freylax/masonry-heater/masonry-heater/calc.org

#+TITLE:     Berechnungen Grundofen Coswiger Str 1
#+AUTHOR:    Robert Hennig
#+EMAIL:     robert.hennig@freylax.de
#+DATE:      2018-08-8 
#+DESCRIPTION: 
#+KEYWORDS: 
#+LANGUAGE:  en
#+OPTIONS:   H:3 toc:2 \n:nil @:t ::t |:t ^:{} -:t f:t *:t <:t
#+OPTIONS:   TeX:t LaTeX:nil skip:nil d:nil todo:t pri:nil tags:not-in-to
#+LATEX_CLASS: articleAivSmall
#+LATEX_HEADER: \usepackage{fancyhdr}
#+LATEX_HEADER: \usepackage{pdfpages}
#+LATEX_HEADER: \usepackage{tabulary}
#+LATEX_HEADER: \pagestyle{fancy}
#+LATEX_HEADER: \fancyhead{} % clear all fields
#+LATEX_HEADER: \fancyhead[RO,LE]{\thepage}
#+LATEX_HEADER: \fancyhead[C]{\slshape\nouppercase{\leftmark}}
#+LATEX_HEADER: \fancyfoot[RO,LE]{\thepage}
#+LATEX_HEADER: \fancyfoot[C]{\slshape Grundofen, Coswiger Str 1, 01445 Radebeul}
#+LATEX_HEADER: \setlength{\headsep}{10pt}
#+LATEX_HEADER: \addtolength{\headheight}{\baselineskip}
#+LATEX_HEADER: \renewcommand{\headrulewidth}{0.4pt}
#+LATEX_HEADER: \renewcommand{\footrulewidth}{0.4pt}
#+INFOJS_OPT: view:nil toc:nil ltoc:t mouse:underline buttons:0 path:http://orgmode.org/org-info.js
#+EXPORT_SELECT_TAGS: export
#+EXPORT_EXCLUDE_TAGS: noexport
#+LATEX_COMPILER: latexmk
#+LINK_UP:   
#+LINK_HOME:

* Grundofenberechnung nach EN 15544 cite:EN15544
** Bestimmung der Nennwärmeleistung (4.1)
   Die aktive Oberfläche des Ofens sind rund $5 m²$.
   Es wird ein mittelschwerer Grundofen errichtet,
   dafür gilt nach cite:Herrmann2011, Seite 229 
\begin{align}
P_n & = A_{GO} \cdot q_{GO} \\
    & = 5 m^2 \cdot 0.75 kW/m^2 = 3.75 kW
\end{align}
** Bestimmung der Brennstoffmasse (4.2)
*** Maximale Brennstoffmasse (4.2.1)
Es eine Speicherdauer von $t_n=8h$ vereinbart, so daß
\begin{align}
m_B & = \frac{P_n \cdot t_n}{3.25} \\
    & = \frac{3.75 \cdot 8}{3.25} & = 9.2 kg
\end{align}
*** Minimale Brennstoffmasse (4.2.2)
\begin{equation}
m_{Bmin} = 0.5 \cdot m_B = 0.5 \cdot 9.2 kg = 4.6 kg
\end{equation}

** Festlegung der wesentlichen Abmessungen (4.3)
*** Brennraum-Innenfläche (4.3.1.1)
\begin{equation}
O_{BR}= 900 \cdot m_{B} = 900 \cdot 9.2 = 8280 cm^2
\end{equation}
*** Brennraum-Grundfläche (4.3.1.2)
\begin{equation}
A_{BRmin}=100 \cdot m_B = 100 \cdot 9.2 = 920 cm^2
\end{equation}
Es wird eine Brennraum Grundfläche von $A_{BR} = 36 cm \times 36 cm = 1296 cm^2$ vereinbart.
\begin{align}
A_{BRmax}& =\frac{900 \cdot m_B - ( 25 + m_B) \cdot U_{BR}}{2} \\
         & =\frac{900 \cdot 9.2 - ( 25 + 9.2) \cdot 4 \cdot 36}{2} = 1677 cm^2
\end{align}
Es ist
\begin{align}
	A_{BRmin} &\le A_{BR} &\le A_{BRmax} \\
	920 cm^2  &\le 1296 cm^2  &\le 1677 cm^2
\end{align}
und die minimale Seitenbreite von $23 cm$ wird eingehalten.
*** Brennraumhöhe (4.3.1.3)
\begin{align}
H_{BR} &\ge 25 + m_B = 25 + 9.2 = 34.2 cm \\
H_{BR} &= \frac{900\cdot m_B - 2 \cdot A_{BR}}{U_{BR}} = \frac{900\cdot 9.2 - 2 \cdot 36 \cdot 36}{4 \cdot 36} = 39.5 cm
\end{align}
Die Brennraumhöhe wird auf $H_{BR} = 40 cm$ festgelegt.

*** Mindestzuglänge (4.3.2.1)
Der Grundofen wird ohne Luftspalt gebaut, dh die Mindestzuglänge ergibt sich zu
\begin{equation}
 L_{Zmin} = 1.3 \cdot \sqrt{m_B} = 1.3 \cdot \sqrt{9.2} = 3.94 m
\end{equation}
*** Gasschlitzquerschnitt (4.3.3)
\begin{equation}
A_{GS} = 1 \cdot m_B = 1 \cdot 9.2 = 9.2 cm^2
\end{equation}

** Verbrennungsluft, Verbrennungsgas
*** Seehöhen-Korrektur (4.6.1.2)
Die geodätische Höhe des Aufstellungsortes ist $ z = 110 m $.
\begin{equation}
f_s = \frac{1}{e^\frac{-9.81 \cdot z}{78624}} = \frac{1}{e^\frac{-9.81 \cdot 110}{78624}} = 1.0138 
\end{equation}

** Temperatur und Druckbedingungen in den Zügen
*** Zuglaengen
Auf der nächsten Seite sind die Züge dargestellt und
in Tabelle [[tbl:zuege]] aufgeführt.    
#+LATEX: \includepdf[pagecommand={},lastpage=1,scale=1]{zuglaengen.pdf}

#+CAPTION: Zuglängen und \zeta Werte
#+NAME: tbl:zuege
|   |      n | $a$ | $b$ | $r$ | \alpha | $L_Z$ | $D_h$ | \zeta |
|   |        |  cm |  cm |  cm |    deg |    cm |    cm |       |
| ! |        |   a |   b |   r |    ang |     l |    Dh |     c |
|---+--------+-----+-----+-----+--------+-------+-------+-------|
| # |      1 |  36 |  36 |     |     90 |    40 |    36 |   1.2 |
| # |      2 |  17 |  17 |     |     90 |    20 |    17 |   1.2 |
| # |      3 |  17 |  17 |     |     90 |    63 |    17 |   1.2 |
| # |      4 |  17 |  17 |     |      0 |    23 |    17 |     0 |
| # |      5 |  17 |  17 |  27 |     96 |    45 |    17 |     1 |
| # |      6 |  17 |  17 |  36 |    111 |    70 |    17 |   1.1 |
| # |      7 |  17 |  17 |     |        |    76 |    17 |     0 |
| # |      8 |  17 |  17 |  31 |     68 |    37 |    17 |   0.8 |
| # |      9 |  17 |  17 |     |        |    38 |    17 |     0 |
| # |     10 |  17 |  17 |  25 |     75 |    33 |    17 |   0.8 |
| # |     11 |  17 |  17 |     |        |    79 |    17 |     0 |
| # |     12 |  15 |  17 |  35 |    109 |    67 |    16 |   1.2 |
| # |     13 |  15 |  17 |     |        |    19 |    16 |     0 |
| # |     14 |  15 |  17 |  18 |     90 |    28 |    16 |   1.1 |
| # |     15 |  15 |  17 |     |        |    35 |    16 |   1.2 |
| # |     16 |  15 |  17 |     |        |   103 |    16 |   0.2 |
| # | vst 17 |  17 |  17 |     |        |    17 |    17 |     0 |
| # | vst 18 |  17 |  17 |  12 |     90 |    19 |    17 |   0.4 |
| # | vst 19 |  17 |  17 |     |        |    26 |    17 |   1.2 |
#+TBLFM: $7=(3.14/180)*$ang*$r;%.0f::$8=(4*$a*$b)/(2*($a+$b));%.0f::@4$7=40::@5$7=20::@6$7=63::@7$7=23::@10$7=76::@12$7=38::@14$7=79::@16$7=19::@18$7=35::@19$7=103::@20$7=17::@22$7=26

*** Temperatur und Druckverlauf in den Zügen
In Tabelle [[tbl:tpz]] ist der Temperatur und Druckverlauf in den Zügen dargestellt.
Der Temperaturverlauf in Verbindungsstück und Schornstein kommt aus den Berechnungen 
aus Abschnitt [[sec:abgas]]

#+LATEX: \begin{landscape}

#+ATTR_LATEX: :font \small
#+ATTR_LATEX: :environment tabulary :width \textwidth :spread
#+CAPTION: Temperatur und Druckverlauf in den Zügen
#+NAME: tbl:tpz 
|   |          Zug | $L_Z$ |  $H$ |  $a$ | $b$ | \zeta | $\sum L_Z$ |   $t$ |     $f_t$ | $\dot{V_G}$ | $\rho_G$ | $p_h$ |   $A$ |  $U$ |   $D_h$ |    $v$ |   $p_d$ | $\lambda_f$ |   $p_r$ |  $p_u$ |
| ! |              |    Lz |    H |    a |   b |     c |        Lzs |     t |        ft |          VG |       rG |    pH |     A |    U |      Dh |      v |      pd |          lf |      pr |     pu |
|   |              |     m |    m |   cm |  cm |       |          m |    °C |           |        m³/s |    kg/m³ |    Pa |    m² |    m |       m |    m/s |      Pa |             |      Pa |     Pa |
|   |              |       |      |      |     |       |            | 4.8.2 |   4.6.1.1 |       4.6.2 |    4.7.2 | 4.9.1 |       |      | 4.9.3.4 |  4.9.2 | 4.9.3.2 |     4.9.3.3 | 4.9.3.1 |  4.9.4 |
|---+--------------+-------+------+------+-----+-------+------------+-------+-----------+-------------+----------+-------+-------+------+---------+--------+---------+-------------+---------+--------|
|   |              |       |      |      |     |       |            |       |           |             |          |       |       |      |         | 1.2..6 |         |             |         |      4 |
| # |              |  0.05 |    0 |   12 |   4 |  0.15 |       0.05 |    18 |     1.066 |       0.027 |    1.186 |  0.00 | 0.005 | 0.32 |   0.062 |  5.400 |  17.292 |       0.070 |   0.976 |  2.594 |
|---+--------------+-------+------+------+-----+-------+------------+-------+-----------+-------------+----------+-------+-------+------+---------+--------+---------+-------------+---------+--------|
| # |            1 |  0.40 |  .40 |   36 |  36 |   1.2 |       0.45 |   700 |     3.564 |       0.091 |    0.355 |  3.57 | 0.130 | 1.44 |   0.361 |  0.700 |   0.087 |       0.036 |   0.003 |  0.104 |
|---+--------------+-------+------+------+-----+-------+------------+-------+-----------+-------------+----------+-------+-------+------+---------+--------+---------+-------------+---------+--------|
| # |            2 |   .20 |    0 |   16 |  10 |   1.2 |       0.65 |   495 |     2.813 |       0.072 |    0.450 |  0.00 | 0.016 | 0.52 |   0.123 |  4.500 |   4.556 |       0.052 |   0.385 |  5.467 |
| # |            3 |   .63 | -.63 |   17 |  17 |   1.2 |       1.28 |   454 |     2.663 |       0.068 |    0.475 | -4.88 | 0.029 | 0.68 |   0.171 |  2.345 |   1.306 |       0.046 |   0.221 |  1.567 |
| # |            4 |   .23 |    0 |   17 |  17 |     0 |       1.51 |   414 |     2.516 |       0.064 |    0.503 |  0.00 | 0.029 | 0.68 |   0.171 |  2.207 |   1.225 |       0.046 |   0.076 |  0.000 |
| # |            5 |   .45 |    0 |   17 |  17 |   1.0 |       1.96 |   386 |     2.414 |       0.061 |    0.524 |  0.00 | 0.029 | 0.68 |   0.171 |  2.103 |   1.159 |       0.046 |   0.140 |  1.159 |
| # |            6 |   .70 |    0 |   17 |  17 |   1.1 |       2.66 |   342 |     2.253 |       0.057 |    0.561 |  0.00 | 0.029 | 0.68 |   0.171 |  1.966 |   1.084 |       0.046 |   0.204 |  1.192 |
| # |            7 |   .76 |    0 |   17 |  17 |     0 |       3.42 |   293 |     2.073 |       0.053 |    0.610 |  0.00 | 0.029 | 0.68 |   0.171 |  1.828 |   1.019 |       0.046 |   0.208 |  0.000 |
| # |            8 |   .37 |    0 |   17 |  17 |   0.8 |       3.79 |   260 |     1.952 |       0.050 |    0.648 |  0.00 | 0.029 | 0.68 |   0.171 |  1.724 |   0.963 |       0.046 |   0.096 |  0.770 |
| # |            9 |   .38 |    0 |   17 |  17 |     0 |       4.17 |   240 |     1.879 |       0.048 |    0.673 |  0.00 | 0.029 | 0.68 |   0.171 |  1.655 |   0.922 |       0.046 |   0.094 |  0.000 |
| # |           10 |   .33 |    0 |   17 |  17 |   0.8 |        4.5 |   223 |     1.817 |       0.046 |    0.696 |  0.00 | 0.029 | 0.68 |   0.171 |  1.586 |   0.875 |       0.046 |   0.078 |  0.700 |
| # |           11 |   .79 |    0 |   16 |  17 |     0 |       5.29 |   198 |     1.725 |       0.044 |    0.733 |  0.00 | 0.027 | 0.66 |   0.164 |  1.630 |   0.974 |       0.047 |   0.221 |  0.000 |
| # |           12 |   .67 |    0 |   15 |  17 |   1.2 |       5.96 |   170 |     1.623 |       0.041 |    0.779 |  0.00 | 0.025 | 0.64 |   0.156 |  1.640 |   1.048 |       0.048 |   0.216 |  1.258 |
| # |           13 |   .19 |    0 |   15 |  17 |     0 |       6.15 |   155 |     1.568 |       0.040 |    0.806 |  0.00 | 0.025 | 0.64 |   0.156 |  1.600 |   1.032 |       0.048 |   0.060 |  0.000 |
| # |           14 |   .28 |    0 |   15 |  17 |   1.1 |       6.43 |   148 |     1.542 |       0.039 |    0.820 |  0.00 | 0.025 | 0.64 |   0.156 |  1.560 |   0.998 |       0.048 |   0.086 |  1.098 |
| # |           15 |   .35 |    0 |   15 |  17 |   1.2 |       6.78 |   138 |     1.505 |       0.038 |    0.840 |  0.00 | 0.025 | 0.64 |   0.156 |  1.520 |   0.970 |       0.048 |   0.104 |  1.164 |
| # |           16 |  1.03 | 1.03 |   15 |  17 |   0.2 |       7.81 |   120 |     1.440 |       0.037 |    0.878 |  3.90 | 0.025 | 0.64 |   0.156 |  1.480 |   0.962 |       0.048 |   0.305 |  0.192 |
|---+--------------+-------+------+------+-----+-------+------------+-------+-----------+-------------+----------+-------+-------+------+---------+--------+---------+-------------+---------+--------|
| # |          vst |  0.62 | 0.29 | 17.0 |     |   1.4 |       8.43 |   118 |     1.432 |       0.036 |    0.883 |  1.08 | 0.023 | 0.53 |   0.174 |  1.565 |   1.081 |       0.040 |   0.154 |  1.513 |
| # |          sch |   7.1 |  7.1 | 17.8 |     |  0.01 |      15.53 |   108 |     1.396 |       0.036 |    0.906 | 24.94 | 0.025 | 0.56 |   0.179 |  1.440 |   0.939 |       0.039 |   1.453 |  0.009 |
|---+--------------+-------+------+------+-----+-------+------------+-------+-----------+-------------+----------+-------+-------+------+---------+--------+---------+-------------+---------+--------|
| # | $\sum total$ |       |      |      |     |       |      15.53 |    98 |           |             |          | 28.61 |       | 0.00 |         |        |  38.492 |             |    5.08 | 22.787 |
| ^ |              |       |      |      |     |       |            |       |           |             |          |   SpH |       |      |         |        |     SpD |             |     Spr |    Spu |
| # |  $\sum ofen$ |       |      |      |     |       |            |       |           |             |          |  2.59 |       |      |         |        |         |             |   2.497 | 14.671 |
| ^ |              |       |      |      |     |       |            |       |           |             |          |  SpHo |       |      |         |        |         |             |    Spro |   Spuo |
| $ |              |       |      |      |     |       |            |       |  Lzm=3.94 |      mB=9.2 | rL=1.264 |       |       |      |         |        |         |             |         |        |
| $ |              |       |      |      |     |       |            |       | fs=1.0138 |             |          |       |       |      |         |        |         |             |         |        |
#+TBLFM: $8=$Lz+@-1$Lzs::$10=(273+$t)/273;%.3f::$11=0.00273*$mB*($ft*$fs;%.3f::$12=1.282/($ft*$fs);%.3f::$13=9.81*$H*($rL-$rG);%.2f::$16=4.*$A/$U;%.3f::$17=$VG/$A;%.3f::$18=0.5*$rG*$v*$v;%.3f::$20=$lf*$pd*$Lz/$Dh;%.3f::$21=$c*$pd;%.3f::@6$14..@22$14=$a*$b/10000;%.3f::@6$15..@22$15=2*($a+$b)/100;%.2f::@6$19..@22$19=1/(1.14+2*log10($Dh/0.003))^2;%.3f::@8$9..@22$9=550*exp(-0.83*($Lzs-$Lz/2-@II-1$Lzs)/$Lzm);%.0f::@23$9=remote(tbl:TempT,@5$tmv)::@23$14..@24$14=0.785*$a*$a/10000;%.3f::@23$15..@24$15=3.14*$a/100;%.2f::@23$19..@24$19=1/(1.14+2*log10($Dh/0.002))^2;%.3f::@24$9=remote(tbl:TempT,@5$tm)::@25$10=string("")::@25$11=string("")::@25$12=string("")::@25$13=vsum(@5..@24)::@25$14=string("")::@25$16=string("")::@25$17=string("")::@25$18=vsum(@5..@24)::@25$19=string("")::@25$20=vsum(@5..@24)::@25$21=vsum(@5..@24)::@27$8=string("")::@27$10=string("")::@27$11=string("")::@27$12=string("")::@27$13=vsum(@II..@IIII)::@27$16=string("")::@27$17=string("")::@27$18=string("")::@27$20=vsum(@II..@IIII)::@27$21=vsum(@II..@IIII)

#+LATEX: \end{landscape}

*** Funktionskontrolle (4.10)

#+CAPTION: Druckvergleich, Wirkungsgrad
#+NAME: tbl:pcomp
|   | $\sum p_r+ \sum p_u \le$ | $\sum p_h$ | $\le 1.05\cdot (\sum p_r+ \sum p_u)$ | $t_F$ |   \eta |
|   | Pa                       | Pa         |                                   Pa | °C    |        |
|   |                          |            |                               4.10.1 |       | 4.10.3 |
|---+--------------------------+------------+--------------------------------------+-------+--------|
| ! |                          |            |                                      | tF    |        |
| # | 27.87                    | 28.61      |                                29.26 | 120   | 89.653 |
#+TBLFM: @5$2=remote(tbl:tpz,$Spr)+remote(tbl:tpz,$Spu);%.2f::@5$3=remote(tbl:tpz,$SpH)::@5$4=1.05*$2;%.2f::@5$5=remote(tbl:tpz,@22$t)::@5$6=101.09-0.0941*$tF-6.275e-6*$tF^2-3.173*10e-9*$tF^3;%.3f

In der Tabelle [[tbl:pcomp]] sind die Ergebnisse dargestellt.
Da sich die Druckwerte im Schornstein und Verbindungsstück je nach Berechnungsmodell (EN 13384-1 ist feiner als EN 15544) 
unterscheiden wurden in Tabelle [[tbl:pcomp2]] die Druckwertewerte aus der Berechnung nach EN 13384-1 eingesetzt (Tabelle [[tbl:psch]]),
und mit den Werten vom Ofen aus Tabelle [[tbl:tpz]]  kombiniert. $P_B'$ ist die Summe aus $P_B=4Pa$ und dem Druck durch die Luftzufuhr
des Ofen, welche in etwa den Werten aus Tabelle [[tbl:tpz]] entspricht.

#+CAPTION: Druckvergleich nach EN 13384-1 und EN 15544
#+NAME: tbl:pcomp2
|   | $P_B'$ | $\sum p_{ru} \le$ | $\sum p_H$ | \le $1.05 \cdot \sum p_{ru}$ |
|   | Pa     | Pa                | Pa         | Pa                           |
|---+--------+-------------------+------------+------------------------------|
| ! | PB     | SPRU              |            |                              |
| # | 6.7    | 26.5              |       27.7 | 27.8                         |
#+TBLFM: $3=remote(tbl:tpz,$Spro)+remote(tbl:tpz,$Spuo)+remote(tbl:psch,$PR1)+remote(tbl:psch,$PR2)+$PB;%.1f::$4=remote(tbl:tpz,$SpHo)+remote(tbl:psch,$PH1)+remote(tbl:psch,$PH2);%.1f::$5=1.05*$SPRU;%.1f

* Berechnung Abgasanlage nach EN 13384-1 cite:EN13384
 <<sec:abgas>>
** Wärmedurchlasswiderstand für den Schornstein (5.6.3)
#+CAPTION: Wärmedurchlasswiderstand für Schornstein
|   | Schicht      | $D_h$ | $\lambda$      | $1/\Lambda$    |
|   |              |   $m$ | $W/(m\cdot K)$ | $m^2\cdot K/W$ |
|   |              |       | B.5            | A.1            |
|---+--------------+-------+----------------+----------------|
| ! |              |    Dh | lb             | Lr             |
| # | Keramikrohr  | 0.178 | 1.02           | 0.010          |
| # | Mineralwolle |  0.20 | 0.042          | 0.386          |
|   |              |  0.24 |                |                |
|   |              |       |                | 0.396          |
#+TBLFM: $5=(@5$Dh/(2*$lb))*ln(@+1$Dh/$Dh);%.3f::@8$5=vsum(@-3..@-1)

** Taupunkttemperatur 5.7.6
#+CAPTION: Taupunkttemperatur
 |   | Brennstoff          | $f_{m1}$ | $f_W$ | $\sigma(H_2O)$ | $z$ | $T$ | $p_L$ | $p_D$ | $t_p$ |
 |   |                     |          | %     | %              | m   | °C  |    Pa | Pa    | °C    |
 |   | $\sigma(CO_2)=20.5$ | B.1      | B.1   | B.5            |     |     | 5.7.2 | B.6   | B.7   |
 |---+---------------------+----------+-------+----------------+-----+-----+-------+-------+-------|
 | ! |                     | fm1      | fw    | sH2O           | z   | t   |    pL | pD    | tP    |
 | # | Holz 30% feucht     | 6.89     | 90    | 19.652         | 119 | 0   | 95570 | 18781 | 58.7  |
 | # | Holz 50% feucht     | 7.08     | 72    | 23.262         | 119 | 0   | 95570 | 22231 | 62.4  |
 | $ | sCO2=20.5           |          |       |                |     |     |       |       |       |
 #+TBLFM: $5=1.1+(100/(1+$fw/$sCO2));%.3f::$8=97000*exp(-9.81*$z/(288*($t+273)));%.0f::$9=($sH2O/100)*$pL;%.0f::$10=(4077.9/(23.6448-ln($pD)))-236.67;%.1f

#+LATEX: \begin{landscape}
** Temperaturwerte 5.8

#+CAPTION: Berechnung der Abkühlzahl K
#+NAME: tbl:TempK
#+ATTR_LATEX: :font \footnotesize
#+ATTR_LATEX: :environment tabulary :width \textwidth :spread
 |   |           |          | $\lambda_A$          | $L$  | $D_h$ | $\eta_A$       | $c_p$                 | $Pr$     | $R$                   | $\rho_m$ | $w_m$  | $Re$  | $\Psi$ | $\Psi_s$ | $Nu$  | $\alpha_i$            | $\frac{1}{\Lambda}$     | $D_{ha}$ | $k$                    | $K$   |
 |   |           | °C       | $\frac{W}{m\cdot K}$ | $m$  | $m$   | $N\cdot s/m^2$ | $\frac{J}{kg\cdot K}$ |          | $\frac{J}{kg\cdot K}$ | $kg/m³$  | $m/s$  |       |        |          |       | $\frac{W}{m²\cdot K}$ | $\frac{m^2 \cdot K}{W}$ | $m$      | $\frac{W}{m^2\cdot K}$ |       |
 |   |           |          | (B.9)                |      |       | (B.10)         | (B.4)                 | (25)     | (B.3)                 |          |        | (26)  | (35)   | (35)     | (24)  | (23)                  |                         |          | (21)                   | (20)  |
 |---+-----------+----------+----------------------+------+-------+----------------+-----------------------+----------+-----------------------+----------+--------+-------+--------+----------+-------+-----------------------+-------------------------+----------+------------------------+-------|
 | ! |           | tm       | lbA                  | L    | Dh    | nyA            | cP                    | Pr       | R                     | rm       | wm     | Re    | psi    | psis     | Nu    | ali                   | Lr                      | Dha      | k                      | K     |
 | # | vst       | 118      | 0.0300               | 0.62 | 0.170 | 2.027e-05      | 1210                  | 0.818    | 288.590               | 0.847    | 1.676  | 11906 | 0.0377 | 0.0295   | 56.93 | 10.046                | 0.01                    | 0.178    | 4.368                  | 0.037 |
 | ^ |           |          |                      |      | Dh1   |                |                       |          |                       |          |        | Re1   |        |          |       |                       |                         |          |                        | K1    |
 | # | sch       | 108      | 0.0293               | 7.1  | 0.178 | 1.984e-05      | 1207                  | 0.817    | 288.590               | 0.869    | 1.490  | 11617 | 0.0408 | 0.0297   | 44.67 | 7.353                 | 0.396                   | 0.24     | 1.601                  | 0.163 |
 | ^ |           |          |                      |      | Dh2   |                |                       |          |                       |          |        | Re2   |        |          |       |                       |                         |          |                        | K2    |
 | $ | sCO2=20.5 | fc0=18.5 | fc1=.016             |      |       | fc2=-1e-5      | fc3=0.0091            | pL=95570 | fR=0.0001             |          | mB=9.2 |       |        |          |       | ala=8                 |                         |          |                        |       |
 #+TBLFM: $4=0.0223+0.000065*$tm;%.4f::$7=15e-6 + (47e-9 * $tm) - (20e-12 * $tm^2);%.3e::$8=(1011+(0.05*$tm)+(0.0003*$tm^2)+(($fc0+($fc1*$tm)+($fc2*$tm^2))*$sCO2))/(1+($fc3*$sCO2));%.0f::$9=$nyA*$cP/$lbA;%.3f::$10=288*(1+($fR*$sCO2));%.3f::$11=$pL/($R*(273+$tm));%.3f::$12=$mB*0.0035/(0.785*$Dh^2*$rm);%.3f::$13=($wm*$Dh*$rm)/$nyA;%.0f::$16=($psi/$psis)^0.67 * 0.0214*($Re^0.8 - 100)*$Pr^0.4 *(1 + ($Dh/$L)^0.67);%.2f::$17=($lbA*$Nu)/$Dh;%.3f::$20=1/( (1/$ali) + $Lr + $Dh/($Dha*$ala));%.3f::$21=(3.14*$Dh*$k*$L)/($mB*0.0035*$cP);%.3f::@5$3=remote(tbl:TempT,@5$12);E::@5$14=remote(tbl:Psi,$psi1);%.4f::@5$15=remote(tbl:Psi,$psi1s);%.4f::@7$3=remote(tbl:TempT,@5$13);E::@7$14=remote(tbl:Psi,$psi2);%.4f::@7$15=remote(tbl:Psi,$psi2s);%.4f

#+CAPTION: Rohrreibungszahl $\Psi$ nach 5.10.3.3 (35) 
#+NAME: tbl:Psi
 |   |                |  $Re$ | $D_h$ |    $r$ | $\frac{1}{\sqrt{\Psi}}$ | $\Psi$      |
 |   |                |       |     m |      m |                         |             |
 |---+----------------+-------+-------+--------+-------------------------+-------------|
 | ! |                |    Re |    Dh |      r |                    wpsi | psi         |
 | # | $vst$          | 11981 |  0.17 |  0.001 |               5.1488606 | 0.037720525 |
 | ^ |                | 11906 |  0.17 |        |                         | psi1        |
 | # | $vst_{smooth}$ | 11981 |  0.17 |      0 |               5.8267813 | 0.029453883 |
 | ^ |                | 11906 |  0.17 |        |                         | psi1s       |
 | # | $sch$          | 11660 | 0.178 | 0.0015 |               4.9531167 | 0.040760817 |
 | ^ |                | 11617 | 0.178 |        |                         | psi2        |
 | # | $sch_{smooth}$ | 11660 | 0.178 |      0 |               5.8062571 | 0.029662481 |
 | ^ |                | 11617 | 0.178 |        |                         | psi2s       |
#+TBLFM: $6=-2*log10( (2.51/($Re*sqrt(if("$psi" == "nan", 0.1, $psi)))) + $r/(3.71*$Dh)); E::$7=if("$wpsi"=="nan","nan",1/($wpsi^2));E::@5$3=remote(tbl:TempK,$Re1)::@5$4=remote(tbl:TempK,$Dh1)::@7$3=remote(tbl:TempK,$Re1)::@7$4=remote(tbl:TempK,$Dh1)::@9$3=remote(tbl:TempK,$Re2)::@9$4=remote(tbl:TempK,$Dh2)::@11$3=remote(tbl:TempK,$Re2)::@11$4=remote(tbl:TempK,$Dh2)

#+CAPTION: Temperaturen in Verbindungsstück und Schornstein
#+NAME: tbl:TempT
 |   | $t_w$ | $t_u$ | $t_{uv}$ | $T_w$ | $T_u$ | $T_{uv}$ | $T_e$ | $T_{mv}$ | $T_o$ | $T_m$ | $t_{mv}$ | $t_m$ | $t_o$ |
 |   | °C    | °C    | °C       | K     | K     | K        | K     | K        | K     |       | °C       | °C    | °C    |
 |   |       |       |          |       | (11)  | (11)     | (19)  | (18)     | (17)  | (16)  |          |       |       |
 |---+-------+-------+----------+-------+-------+----------+-------+----------+-------+-------+----------+-------+-------|
 | ! | tw    | tu    | tuv      | Tw    | Tu    | Tuv      | Te    | Tmv      | To    | Tm    | tmv      | tm    | to    |
 | # | 120   | 8     | 20       |   393 |   281 | 293      | 388.9 | 391.0    | 372.7 | 380.6 | 118      | 108   | 100   |
#+TBLFM: $2=remote(tbl:tpz,@22$9)::$5=$tw+273::$6=$tu+273::$7=$tuv+273::$8=$Tu+($Tw-$Tu)*exp(- remote(tbl:TempK,$K1));%.1f::$9=$Tu+(($Tw-$Tu)/remote(tbl:TempK,$K1))*(1-exp(-remote(tbl:TempK,$K1)));%.1f::$10=$Tu+($Te-$Tu)*exp(-remote(tbl:TempK,$K2));%.1f::$11=$Tu+(($Te-$Tu)/remote(tbl:TempK,$K2))*(1-exp(- remote(tbl:TempK,$K2)));%.1f::$12=$Tmv-273;%.0f::$13=$Tm-273;%.0f::$14=$To-273;%.0f

#+LATEX: \end{landscape}

** Ermittlung der Drücke 5.10
#+CAPTION: Drücke in Verbindungsstück und Schornstein
#+NAME: tbl:psch
 |   |     | $pL$  | $\rho_L$ | $T_m$ | $R$                   | $\rho_m$ | $L$  | $H$  | $D_h$ | $P_H$ | $\Psi$ | $w_m$ | $P_R$ |
 |   |     | $Pa$  | $kg/m^3$ | $K$   | $\frac{J}{kg\cdot K}$ | $kg/m^3$ | $m$  | $m$  | $m$   | Pa    |        | $m/s$ | Pa    |
 |   |     |       |          |       | (B.3)                 | (27)     |      |      |       | (31)  |        |       | (33)  |
 |---+-----+-------+----------+-------+-----------------------+----------+------+------+-------+-------+--------+-------+-------|
 | ! |     | pL    | rL       | Tmx   | Rx                    | rm       | Lx   | Hx   | Dh    | PH    |   psix | wmx   | PR    |
 | # | vst | 95570 | 1.216    | 391.  | 288.59                | 0.847    | 0.62 | 0.29 | 0.170 | 1.0   | 0.0377 | 1.676 | 0.245 |
 | ^ |     |       |          |       |                       |          |      |      |       | PH1   |        |       | PR1   |
 | # | sch | 95570 | 1.216    | 380.6 | 288.59                | 0.870    | 7.1  | 7.1  | 0.178 | 24.1  | 0.0408 | 1.49  | 2.357 |
 | ^ |     |       |          |       |                       |          |      |      |       | PH2   |        |       | PR2   |
#+TBLFM: $4=$pL/(288*273);%.3f::$7=$pL/($Rx * $Tmx );%.3f::$11=$Hx*9.81*($rL-$rm);%.1f::$14=1.5*($psix*$Lx/$Dh)*$rm*0.5*$wmx^2;%.3f::@5$5=remote(tbl:TempT,@5$Tmv)::@5$6=remote(tbl:TempK,@5$R)::@5$8=remote(tbl:TempK,@5$L)::@5$9=remote(tbl:tpz,@23$H)::@5$12=remote(tbl:Psi,$psi1);%.4f::@5$13=remote(tbl:TempK,@5$wm)::@7$5=remote(tbl:TempT,@5$Tm)::@7$6=remote(tbl:TempK,@7$R)::@7$8=remote(tbl:TempK,@7$L)::@7$9=remote(tbl:tpz,@24$H)::@7$12=remote(tbl:Psi,$psi2);%.4f::@7$13=remote(tbl:TempK,@7$wm)

#+CAPTION: Druckbedingung
|   | $P_Z\ge$ | $P_{Ze}$ | $Q_N$ | $P_W$ | $P_{FV}$ | $P_B$ |
|   | Pa       | Pa       | $kW$  | Pa    |          | Pa    |
|   | (1)      | (1)      |       | B.2   |          |       |
|---+----------+----------+-------+-------+----------+-------|
| ! | PZ       | PZe      | QN    | PW    | PFV      | PB    |
| # | 21.743   | 13.355   | 3.75  | 8.6   | 0.755    | 4     |
#+TBLFM: $2=remote(tbl:psch,$PH2) - remote(tbl:psch,$PR2)::$3=$PW + $PFV + $PB::$5=15*log10($QN);%.1f::$6=remote(tbl:psch,$PH1) - remote(tbl:psch,$PR1)

Die einzuhaltende Bedingung ist nach (1),5.2.1:   
\begin{align}					   
  P_Z = P_H - P_R \ge P_W + P_{FV} + P_B = P_{Ze} 
\end{align}                                       

bibliography:citations.bib
bibliographystyle:alpha

#+LATEX: \includepdf[pagecommand={},lastpage=1,scale=1,landscape]{ansichten.pdf}
#+LATEX: \includepdf[pagecommand={},lastpage=1,scale=1,landscape]{schnitte.pdf}

# -*- org-latex-prefer-user-labels: t; -*-
