freylax/masonry-heater/masonry-heater/masonry-heater2.fcstd

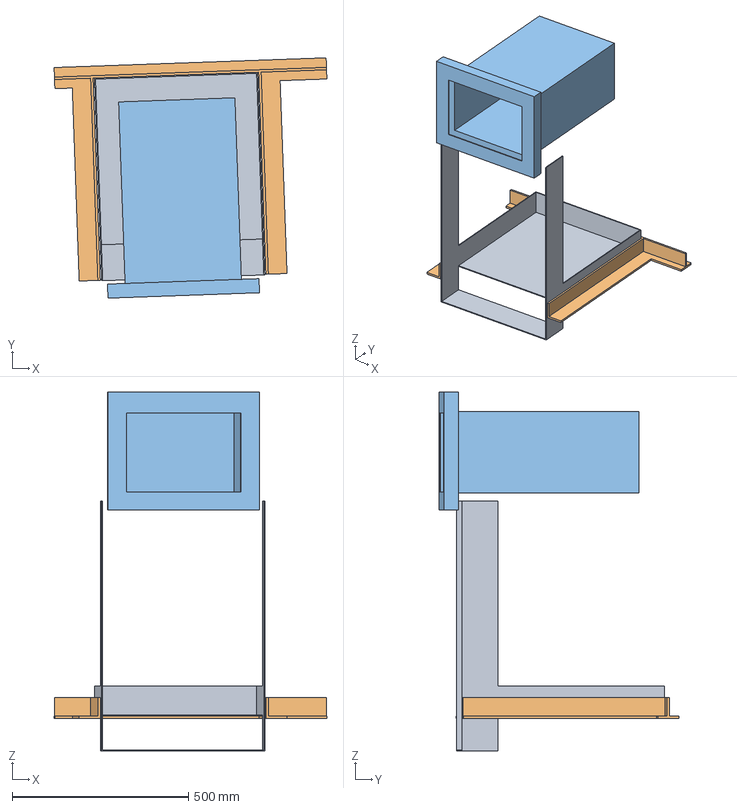
[picture p1: CAD file, 2018-10-09]
masonry-heater/masonry-heater2.fcstd
773.6 x 681.5 x 1018.0 mm
OI-Rahmen
QuerRiegel
