freylax/masonry-heater/masonry-heater/masonry-heater1.fcstd

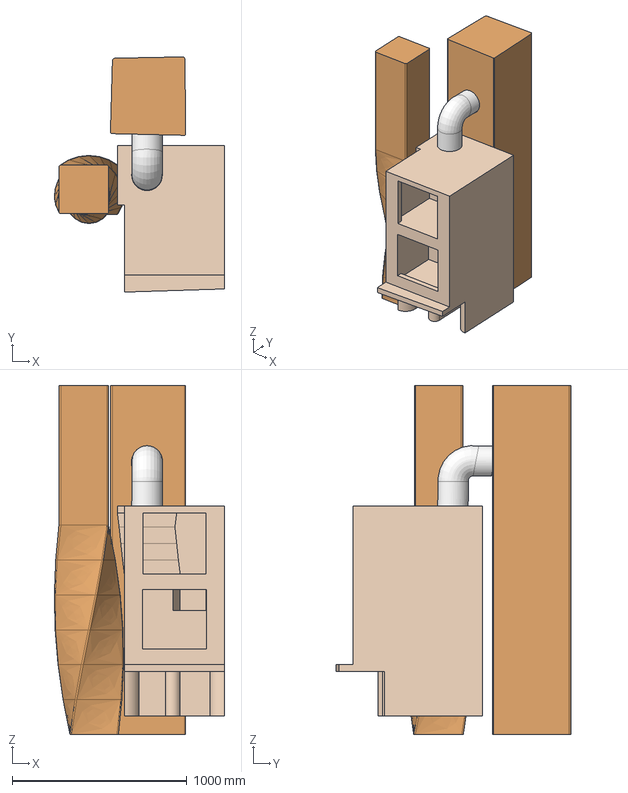
[picture p2: CAD file, 2018-08-23]
masonry-heater/masonry-heater1.fcstd
976.1 x 1347.9 x 2000.0 mm
Schornstein
Sauele
Ofenkoerper
Rohr
Deckel
