freylax/masonry-heater/(commit log)

2018-07-09 added heater
    [masonry-heater.fcstd]
2018-07-11 schamotte platte
    [masonry-heater.fcstd]
2018-10-06 closed shape
    [masonry-heater2.fcstd]
